PBC48/ECE-3400-Fall-2018/README.md

# ECE-3400-Fall-2018

Link to team website: https://pbc48.github.io/ECE-3400-Fall-2018/

Link to Youtube playlist for all clips: https://www.youtube.com/playlist?list=PLlDmQrapOPoI81cNX5rbt9q5gyuW65E6B
