PBC48/ECE-3400-Fall-2018/lab01/lab01.md

# Lab 01

## Blink

## The Serial Monitor and Analog Pins

## LED Analog Output

## Servos

## Robot
