PBC48/ECE-3400-Fall-2018/45593376_284451068862124_2819931915732123648_n.jpg

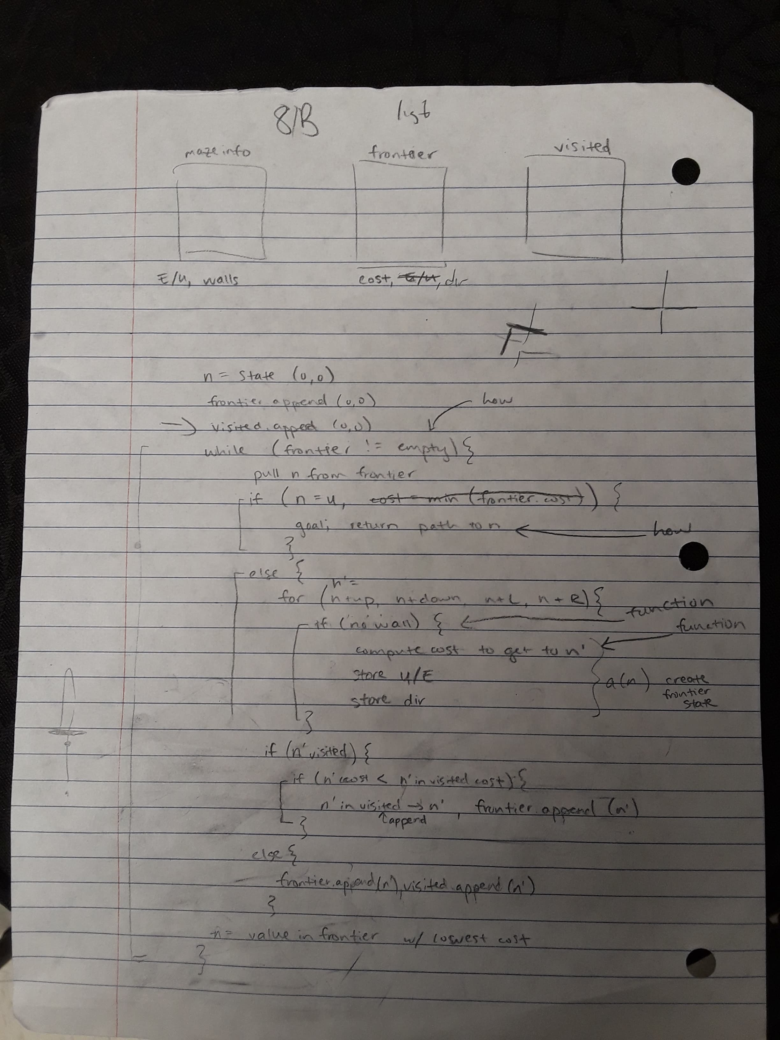
45593376_284451068862124_2819931915732123648_n.jpg
