PBC48/ECE-3400-Fall-2018/docs/css/background-bubbles.jpg

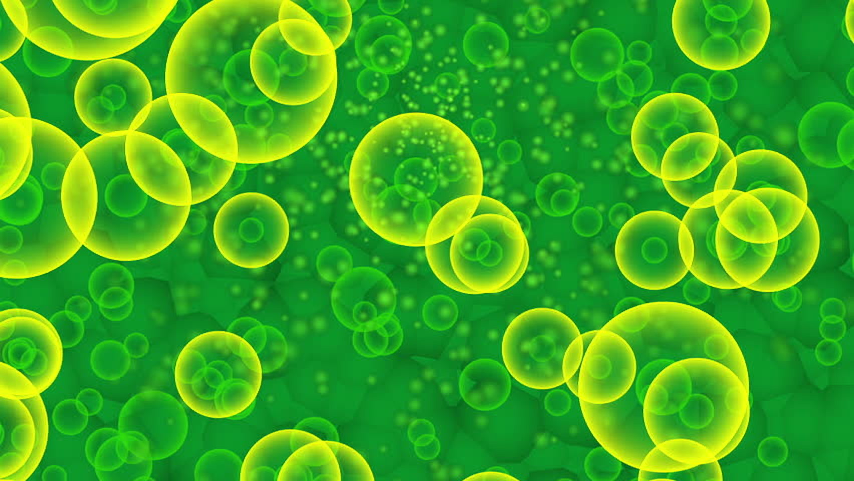
docs/css/background-bubbles.jpg
