PBC48/ECE-3400-Fall-2018/docs/css/bubbles-gif.gif

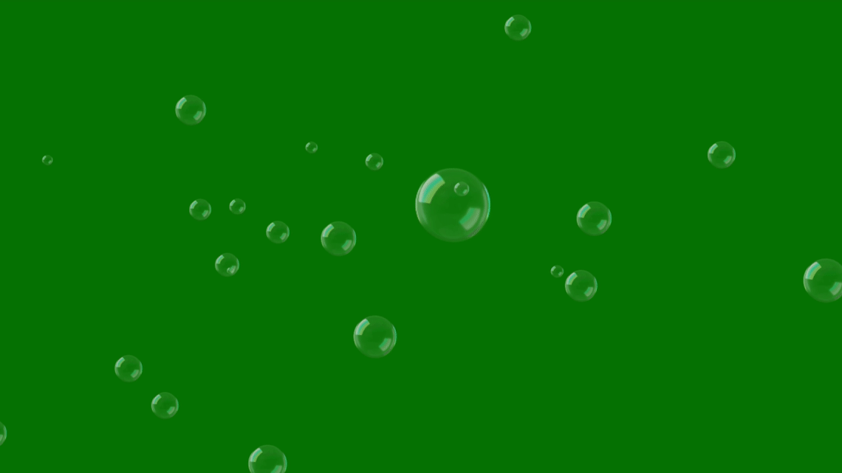
docs/css/bubbles-gif.gif
