PBC48/ECE-3400-Fall-2018/docs/images/bootstrap/contracts.gif

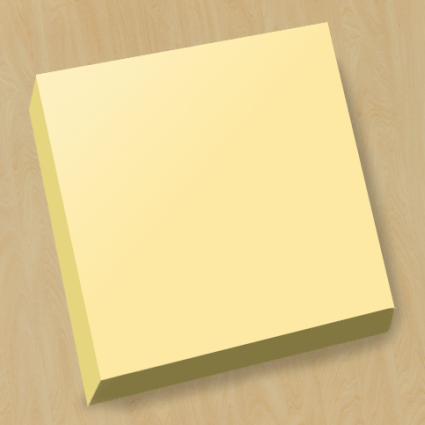
docs/images/bootstrap/contracts.gif
