PBC48/ECE-3400-Fall-2018/docs/images/bootstrap/ethics.gif

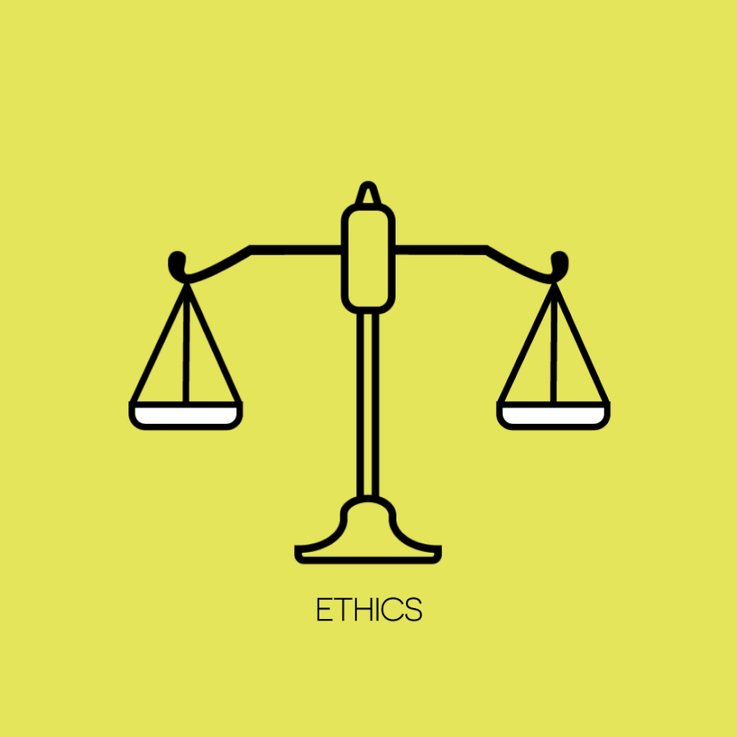
docs/images/bootstrap/ethics.gif
