PBC48/ECE-3400-Fall-2018/docs/images/bootstrap/header.png

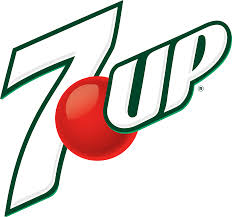
docs/images/bootstrap/header.png
