PBC48/ECE-3400-Fall-2018/docs/images/bootstrap/lab2-bootstrap.png

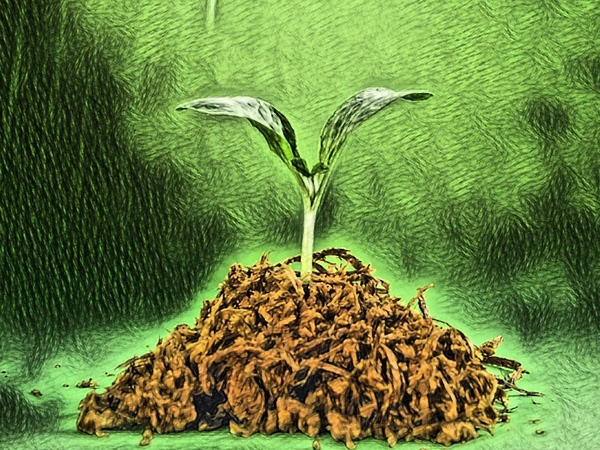
docs/images/bootstrap/lab2-bootstrap.png
