PBC48/ECE-3400-Fall-2018/docs/images/bootstrap/milestone1.png

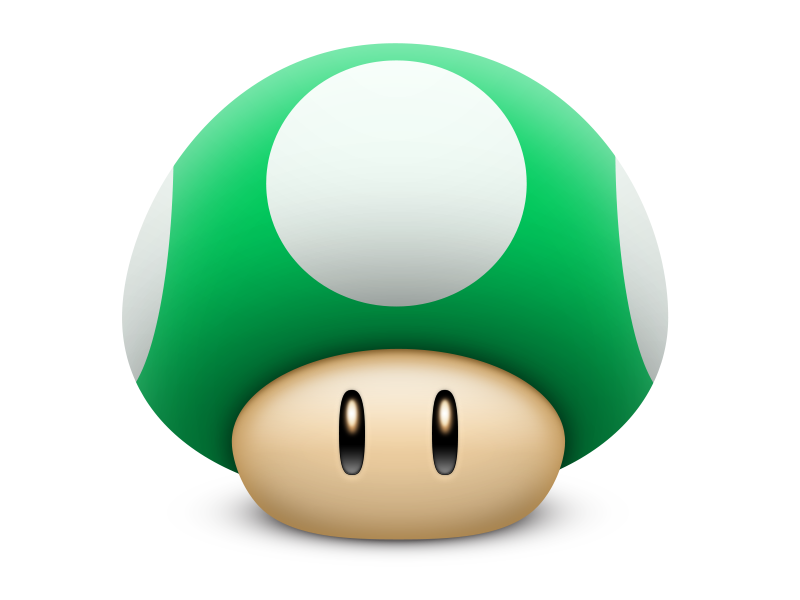
docs/images/bootstrap/milestone1.png
