PBC48/ECE-3400-Fall-2018/docs/images/bootstrap/milestone2.gif

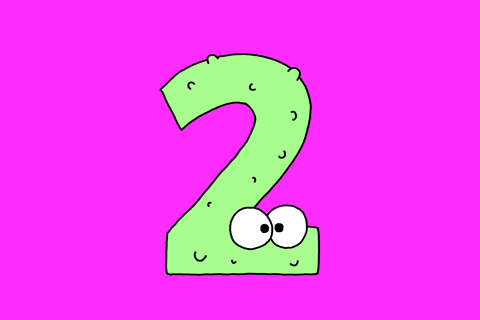
docs/images/bootstrap/milestone2.gif
