PBC48/ECE-3400-Fall-2018/docs/images/bootstrap/milestone4.gif

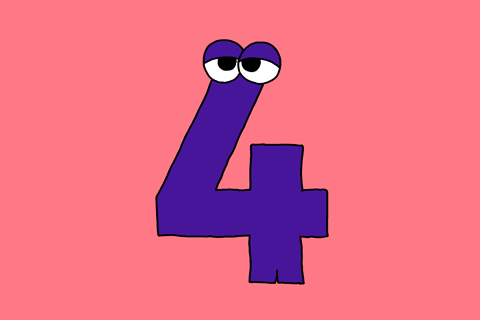
docs/images/bootstrap/milestone4.gif
