PBC48/ECE-3400-Fall-2018/docs/images/Code-serial.PNG

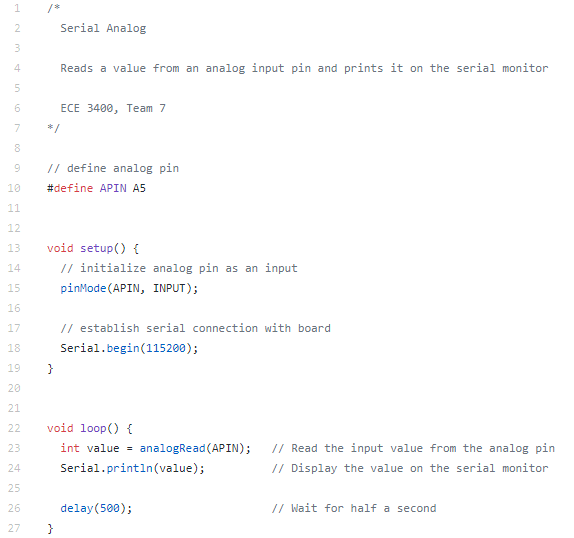
docs/images/Code-serial.PNG
