PBC48/ECE-3400-Fall-2018/docs/images/final_competition/IMG_1189.jpg

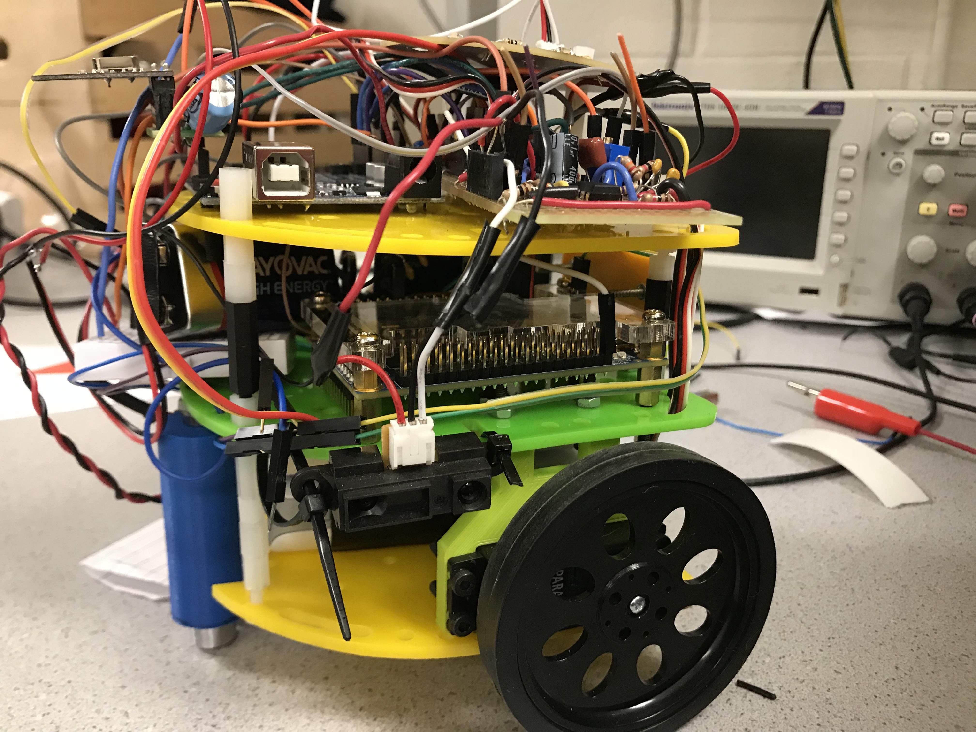
docs/images/final_competition/IMG_1189.jpg
