PBC48/ECE-3400-Fall-2018/docs/images/final_competition/labelrobot6.png

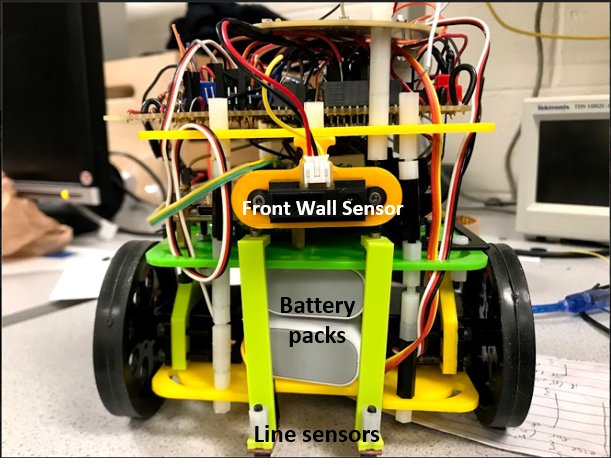
docs/images/final_competition/labelrobot6.png
