PBC48/ECE-3400-Fall-2018/docs/images/final_competition/schematics.PNG

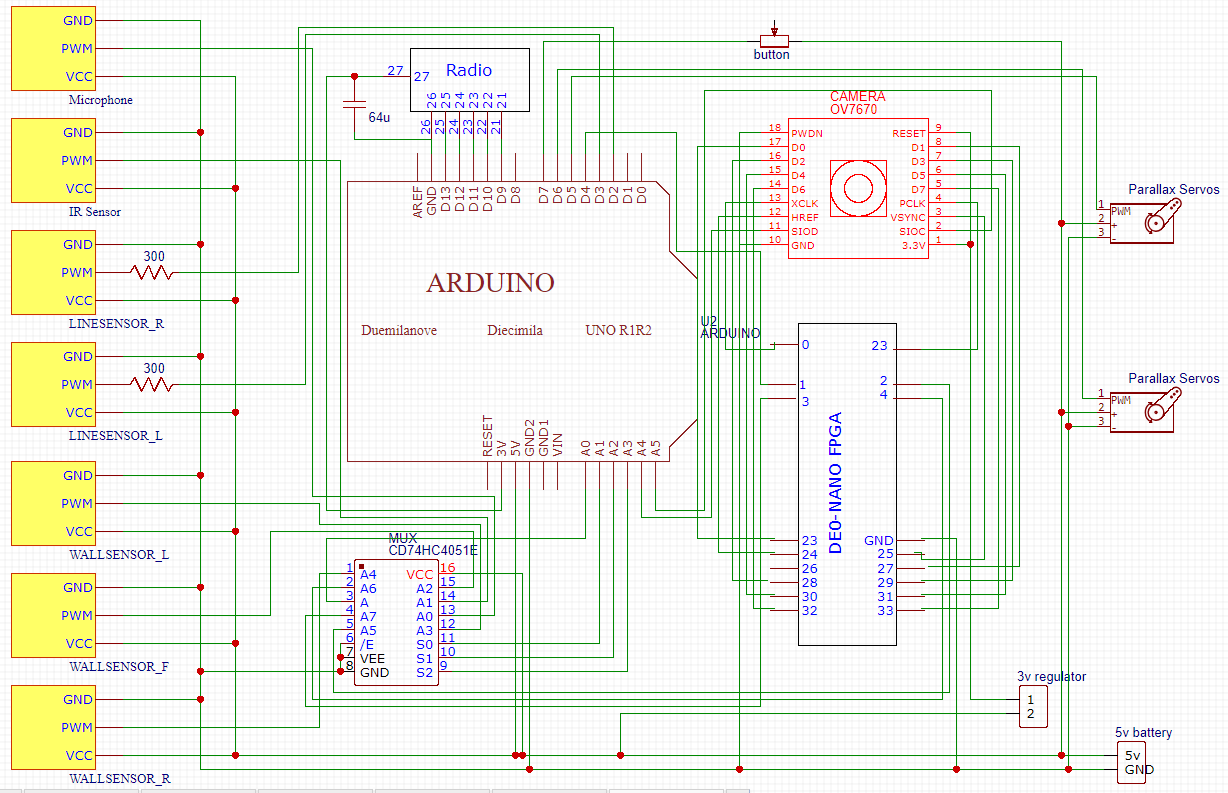
docs/images/final_competition/schematics.PNG
