PBC48/ECE-3400-Fall-2018/docs/images/headshot-Chrissy.png

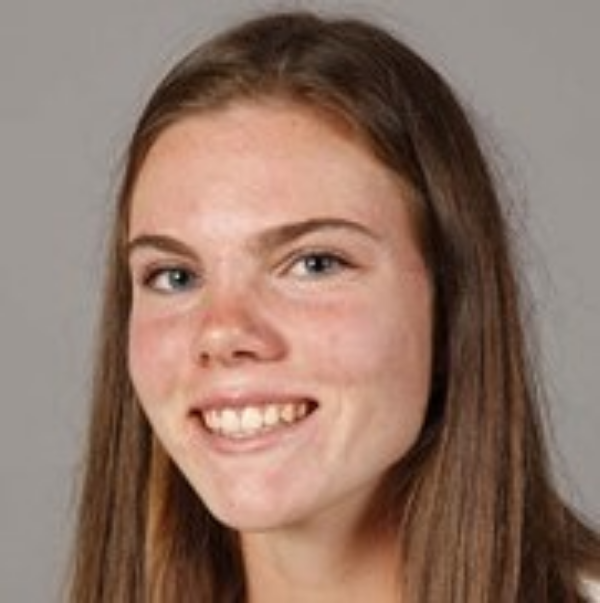
docs/images/headshot-Chrissy.png
