PBC48/ECE-3400-Fall-2018/docs/images/headshot-Patrick.jpeg

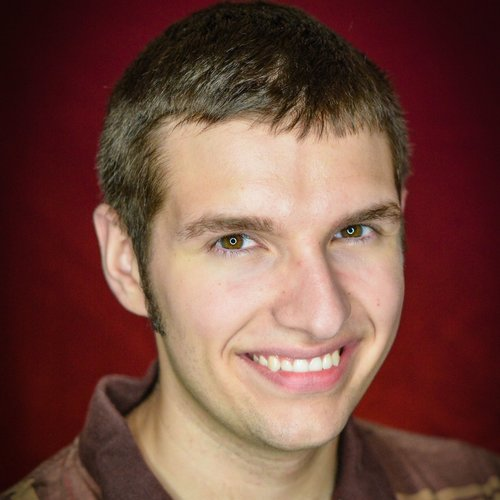
docs/images/headshot-Patrick.jpeg
