PBC48/ECE-3400-Fall-2018/docs/images/headshot-Xiaoyu.PNG

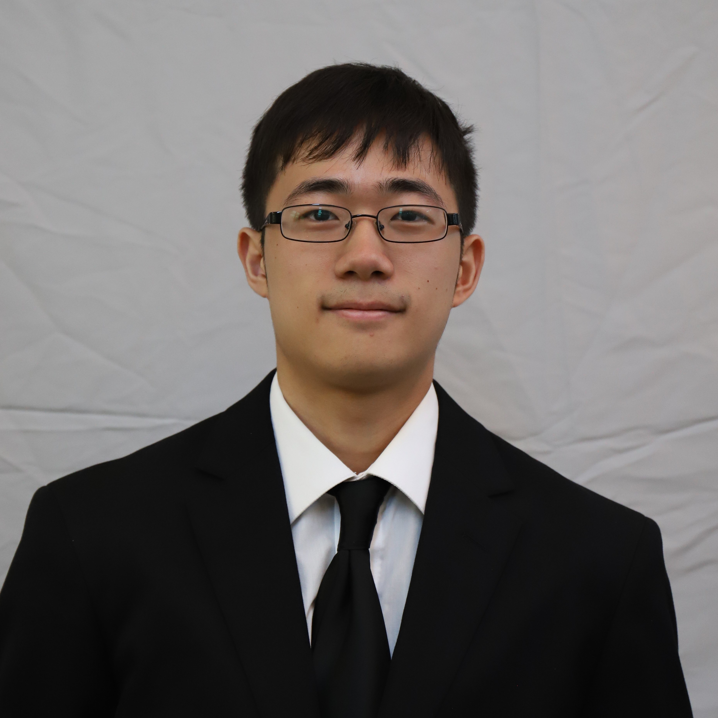
docs/images/headshot-Xiaoyu.PNG
