PBC48/ECE-3400-Fall-2018/docs/images/lab02/amp_input2.jpg

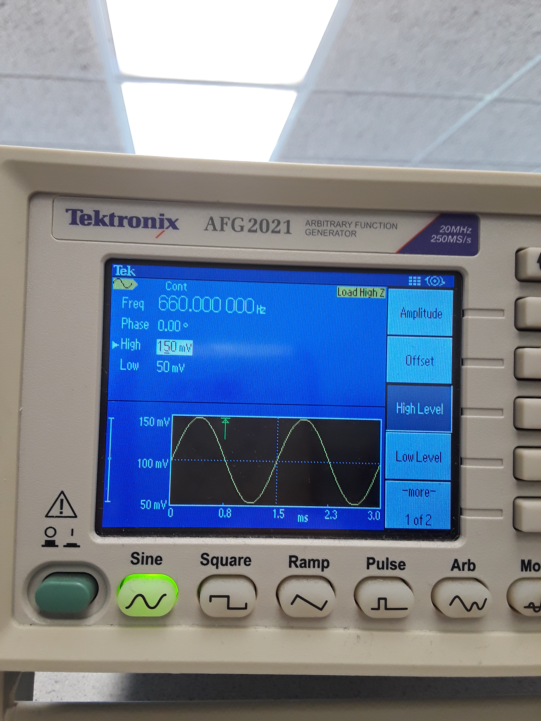
docs/images/lab02/amp_input2.jpg
