PBC48/ECE-3400-Fall-2018/docs/images/lab02/amp_output.jpg

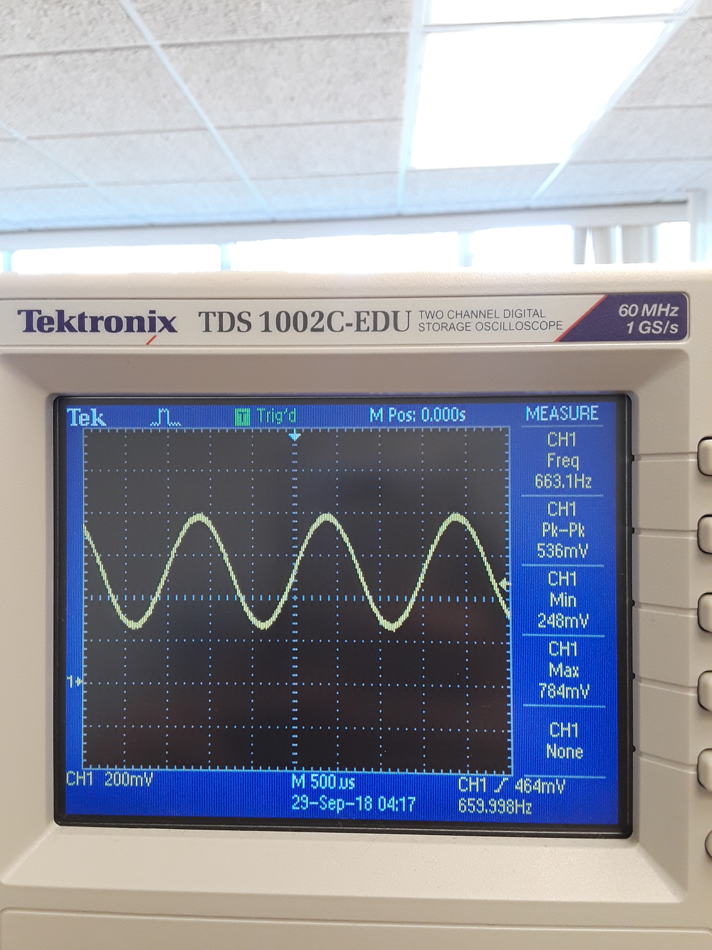
docs/images/lab02/amp_output.jpg
