PBC48/ECE-3400-Fall-2018/docs/images/lab02/IMG_1043.JPG

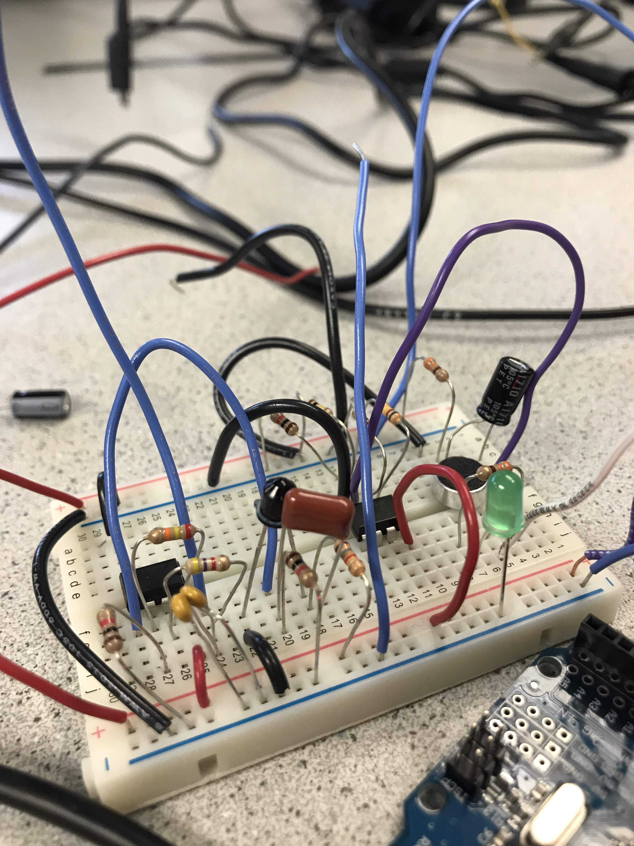
docs/images/lab02/IMG_1043.JPG
