PBC48/ECE-3400-Fall-2018/docs/images/lab02/Lab2integrated_1.PNG

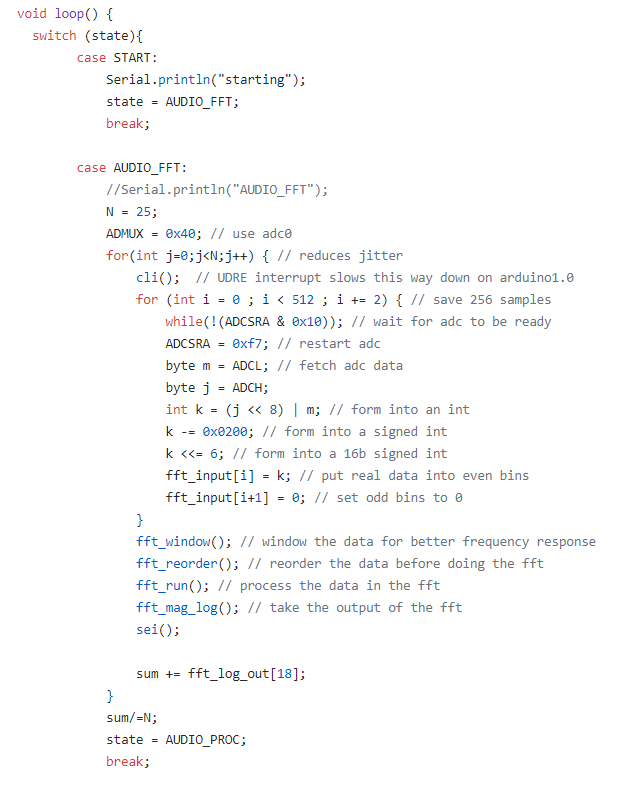
docs/images/lab02/Lab2integrated_1.PNG
