PBC48/ECE-3400-Fall-2018/docs/images/lab02/Lab2integratedcode_2.PNG

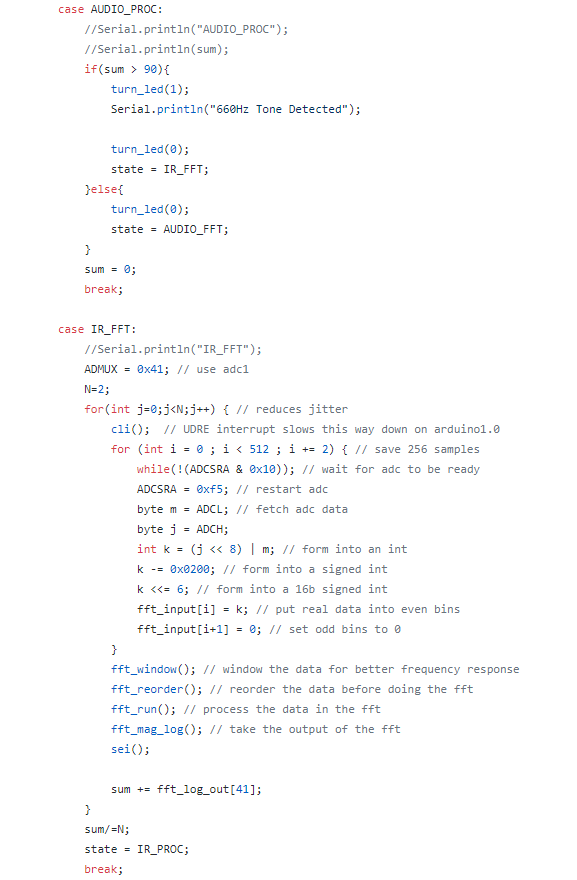
docs/images/lab02/Lab2integratedcode_2.PNG
