PBC48/ECE-3400-Fall-2018/docs/images/lab04/IMG_1161.jpg

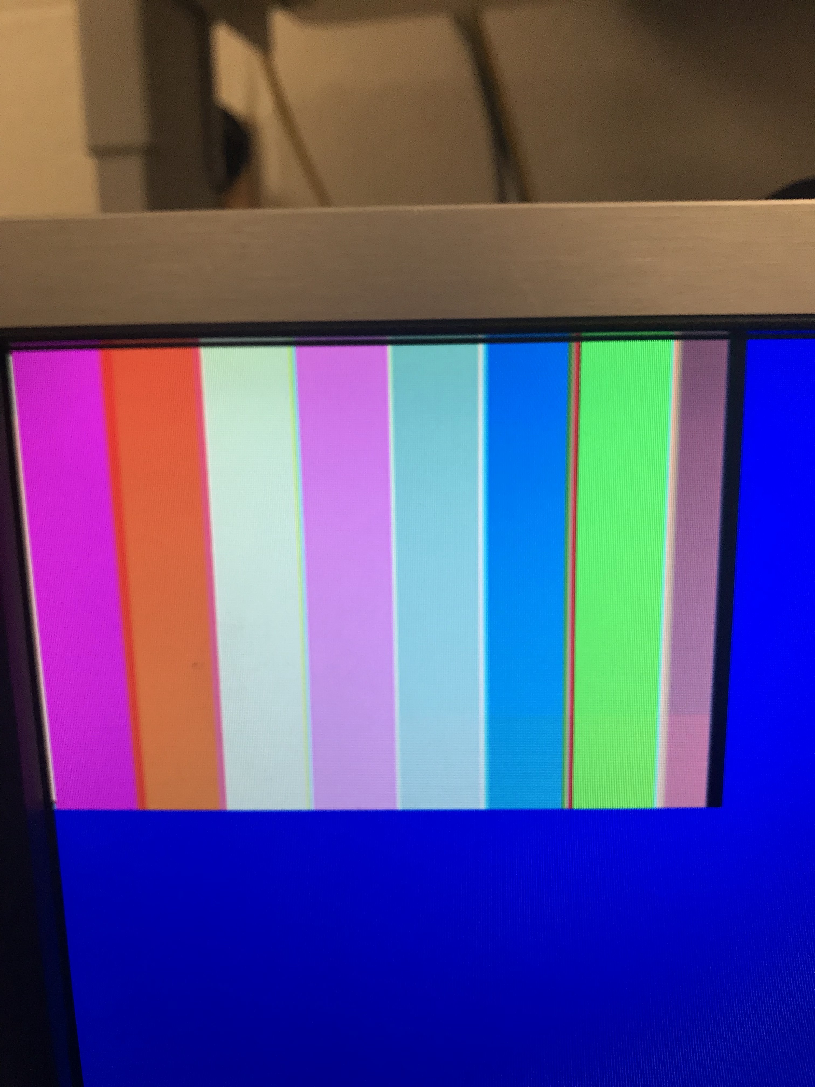
docs/images/lab04/IMG_1161.jpg
