PBC48/ECE-3400-Fall-2018/docs/images/lab04/IMG_1173.jpg

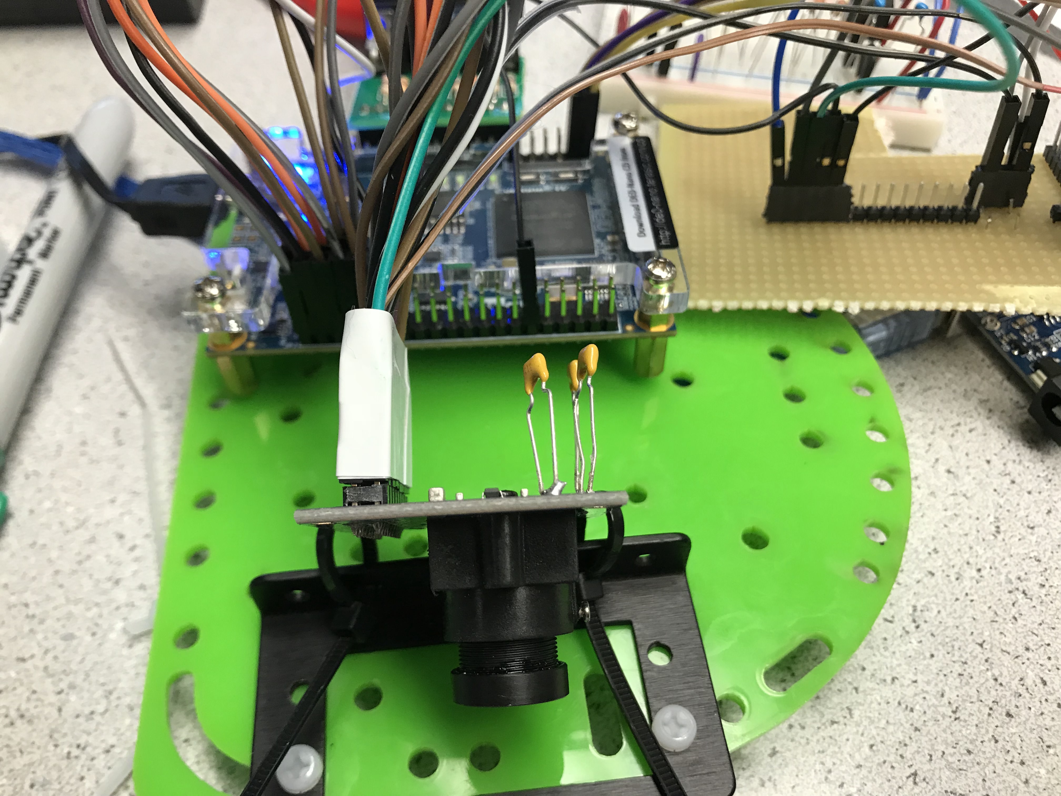
docs/images/lab04/IMG_1173.jpg
