PBC48/ECE-3400-Fall-2018/docs/images/milestone1/20180910_213503.jpg

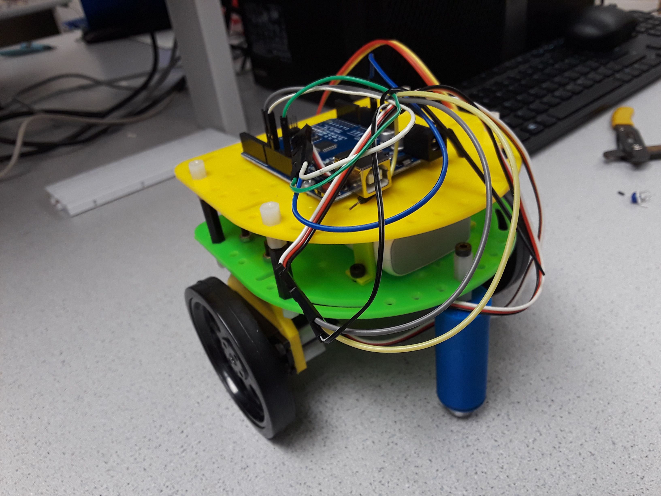
docs/images/milestone1/20180910_213503.jpg
