PBC48/ECE-3400-Fall-2018/docs/images/milestone1/20180913_204701.jpg

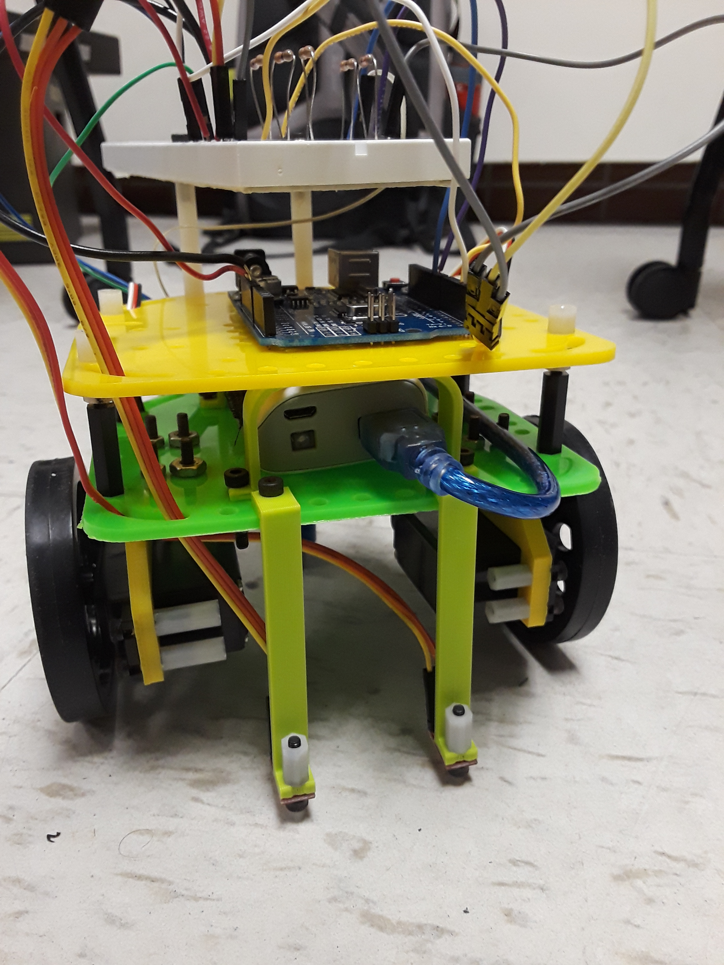
docs/images/milestone1/20180913_204701.jpg
