PBC48/ECE-3400-Fall-2018/docs/images/milestone2/20181017_224123.jpg

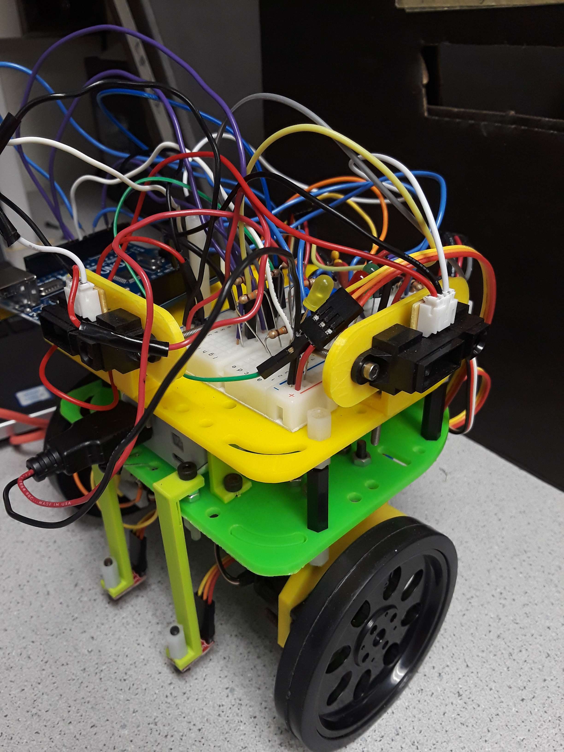
docs/images/milestone2/20181017_224123.jpg
