PBC48/ECE-3400-Fall-2018/docs/images/milestone2/line_sensor_spacers.jpg

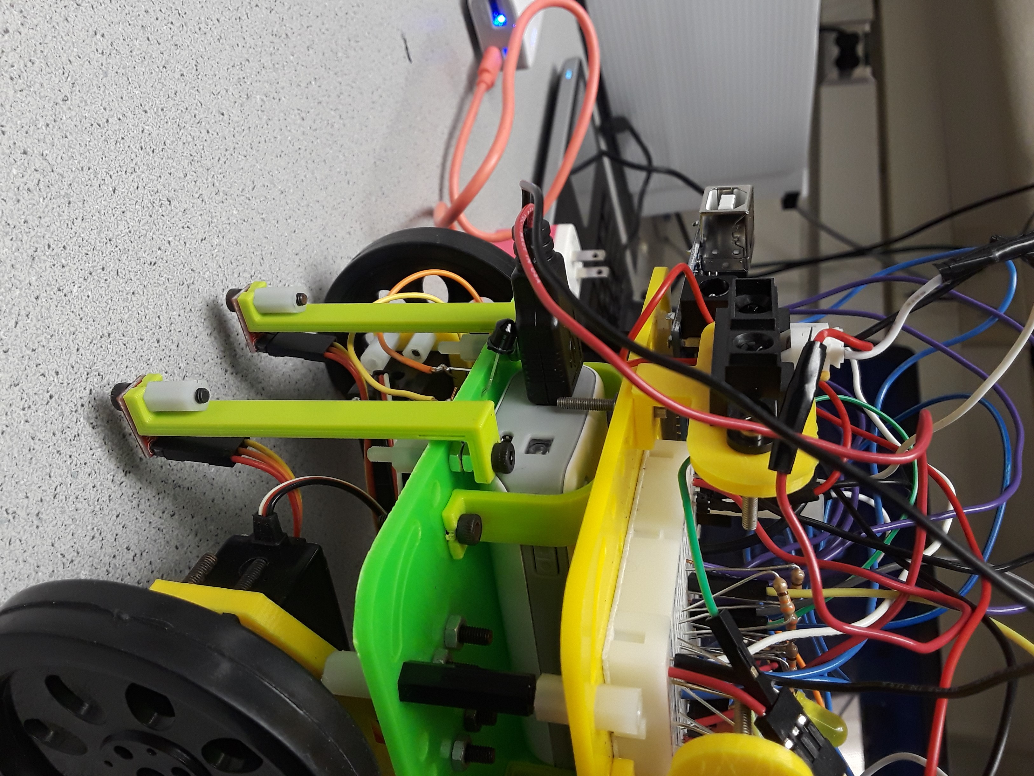
docs/images/milestone2/line_sensor_spacers.jpg
