PBC48/ECE-3400-Fall-2018/docs/images/milestone2/phototransistor.jpg

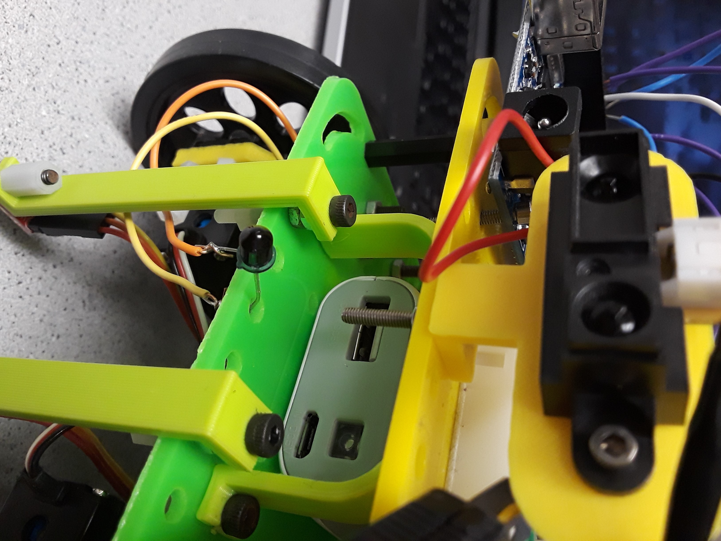
docs/images/milestone2/phototransistor.jpg
