PBC48/ECE-3400-Fall-2018/docs/images/Muxing.png

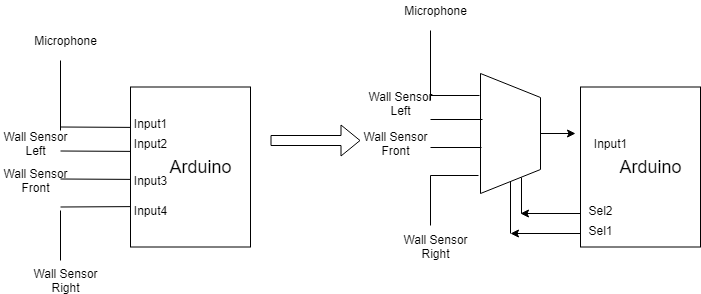
docs/images/Muxing.png
