PBC48/ECE-3400-Fall-2018/docs/images/robottop-v1.PNG

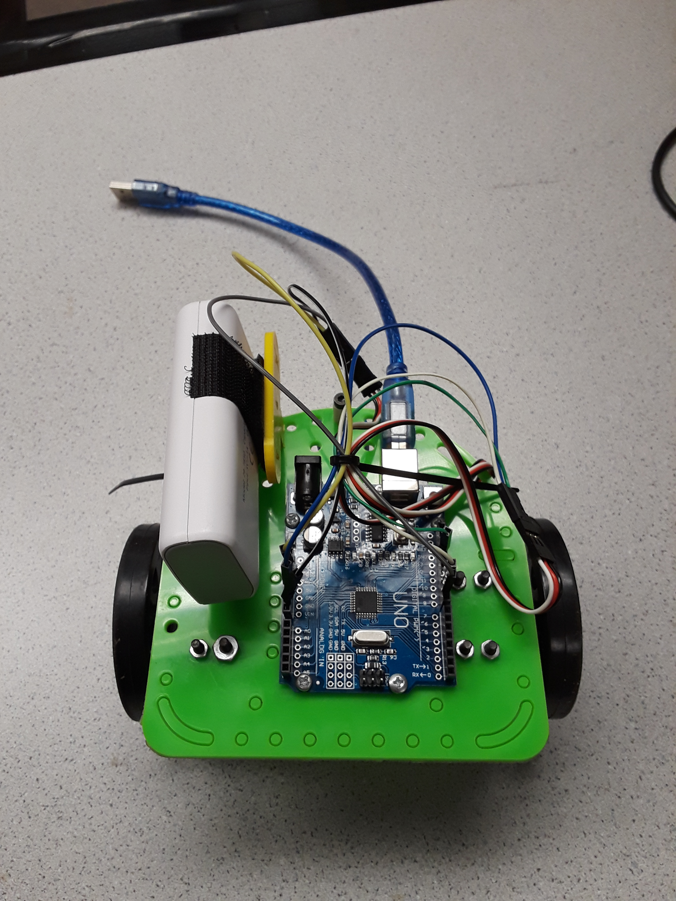
docs/images/robottop-v1.PNG
