PBC48/ECE-3400-Fall-2018/docs/images/robotv1.PNG

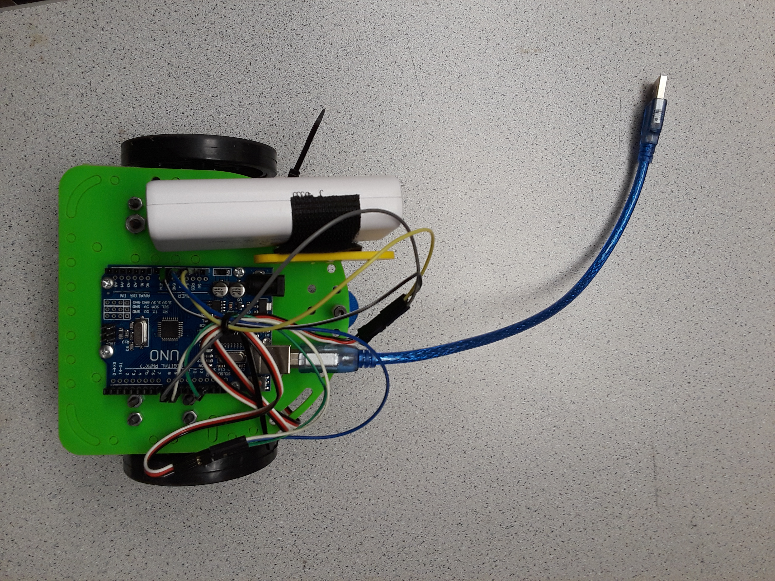
docs/images/robotv1.PNG
