PBC48/ECE-3400-Fall-2018/docs/images/taravn_headshot.jpg

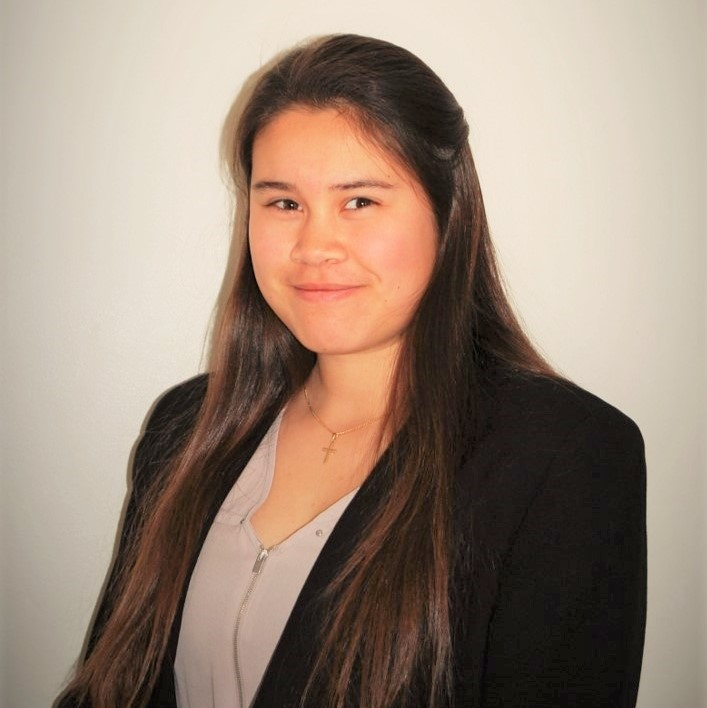
docs/images/taravn_headshot.jpg
