PBC48/ECE-3400-Fall-2018/round1.PNG

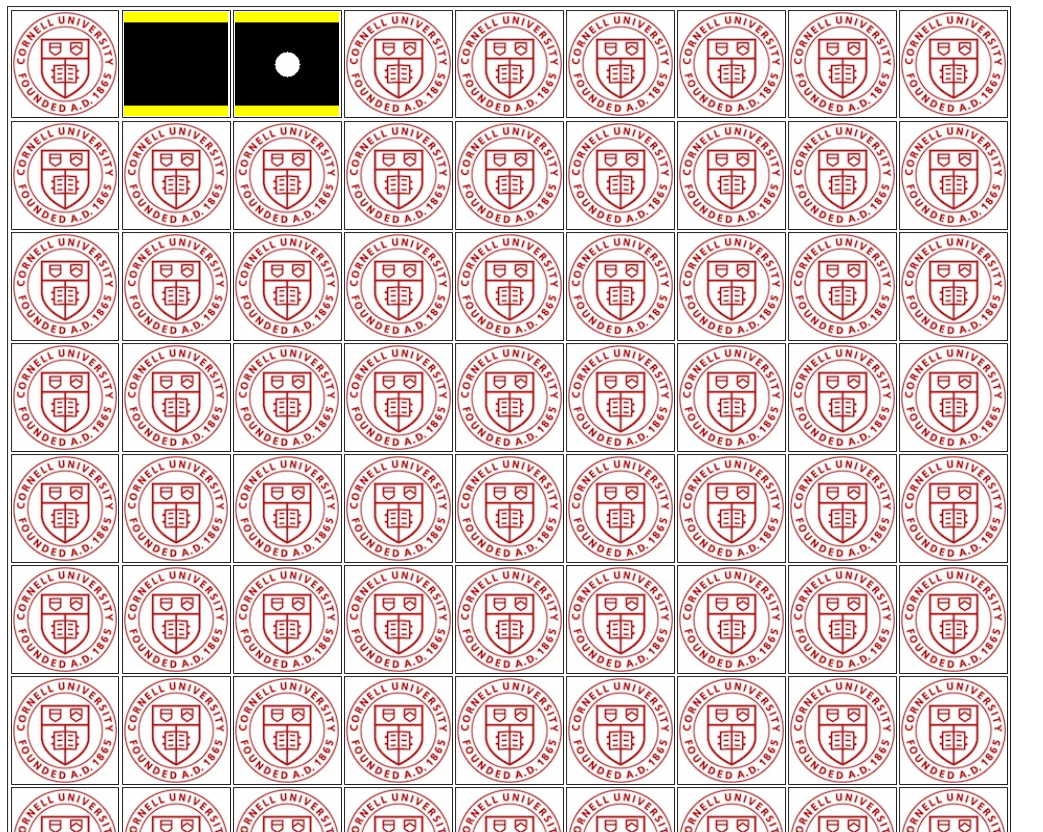
round1.PNG
