PBC48/ECE-3400-Fall-2018/(list of files, cad)

Other CAD files:
blueprints/Battery_mount_tall.dwg
blueprints/bottom_plate.dwg
blueprints/bottom layer w arduino holes.dwg
blueprints/top layer.dwg
