PBC48/ECE-3400-Fall-2018/docs/images/bootstrap/soldering.png

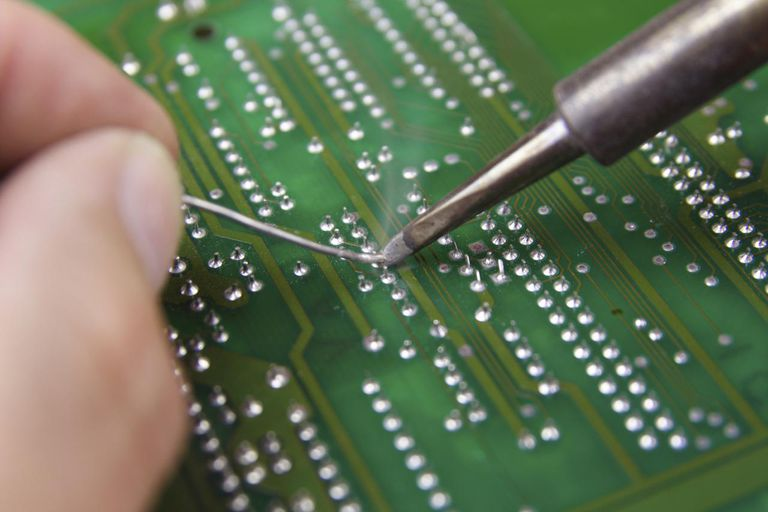
docs/images/bootstrap/soldering.png
