PBC48/ECE-3400-Fall-2018/milestone 4/m4/robot.h

#include <Servo.h>

#define ROBOT_RIGHT_PIN 5
#define ROBOT_LEFT_PIN 6

Servo R;
Servo L;
enum DIRECTIONS : uint8_t
{
    right=1,
    left,
    forward,
    rstop,
    adj_right,
    adj_left,
    back
};

DIRECTIONS current_state;

void robot_move(DIRECTIONS dir)
{
    if (current_state != dir)
    {
        if (dir != rstop && (!R.attached() || !L.attached()))
        {
            Serial.println("in if attach");
            R.attach(ROBOT_RIGHT_PIN);
            L.attach(ROBOT_LEFT_PIN);
        }
        else if (dir == rstop)
        {
            R.detach();
            L.detach();
        }
        switch (dir)
        { //NEED SOME CALIBRATION
        case right:
            L.write(180);
            R.write(95);
            //Serial.println("right");
            break;
        case left:
            L.write(85);
            R.write(0);
            //Serial.println("left");
            break;
        case forward:
            //L.write(150);
            //R.write(30);
            L.write(180);
            R.write(0);
            //Serial.println("forward");
            break;
        case rstop:
            L.write(90);
            R.write(90);
            Serial.println("stopped");
            break;
        case adj_left:
            L.write(90);
            R.write(0);
            //Serial.println("adjust left");
            break;
        case adj_right:
            L.write(180);
            R.write(90);
            //Serial.println("adjust right");
            break;
        case back:
            L.write(0);
            R.write(180);
            Serial.println("back");
            break;
        }
        delay(25); //update the PWM every 20-30 ms.
        current_state = dir;
    }
}

void robot_init()
{
    R.attach(ROBOT_RIGHT_PIN);
    L.attach(ROBOT_LEFT_PIN);
    current_state = 0;
    robot_move(rstop);
}

void servo_detach(){
  R.detach();
  L.detach();
}

void robot_calibrate()
{
    robot_move(right);
    delay(10000);
    robot_move(left);
    delay(10000);
    robot_move(forward);
    delay(10000);
    robot_move(rstop);
    delay(10000);
    robot_move(back);
    delay(10000);
}
