PBC48/ECE-3400-Fall-2018/Milestone 3/milestone3_complicated/milestone3_complicated.ino

/*
milestone 2 code with FSMs where we integrated line sensor, wall 
sensor, robot movement, microphone, and ir all in one.
*/

#define MUX_OUT A0
#define MUX_0 A1
#define MUX_1 A2
#define MUX_2 A3

#define WAITTIME 800
#define BUTTON 7 //Digital pin for button

#include "robot.h"
#include "line_sensor.h"
#include "fft_lib.h"
#include "radio.h"
#include "path.h"
#include "maze.h"


uint8_t robot_pos;


enum states : uint8_t
{
    START,
    AUDIO_DECT,
    IR_DECT,
    ROBOT_SENSE,
    ROBOT_DETECTED,
    ROBOT_TURN_LEFT,
    ROBOT_TURN_RIGHT,
    ROBOT_FORWARD,
    ROBOT_U_TURN,
    TRANSMIT
};

uint8_t STATE;
uint32_t u32wait;
uint32_t u32wait_ir;
uint16_t radio_msg = 0;
uint16_t FRONTWALL;
uint16_t LEFTWALL;
uint16_t RIGHTWALL;

void toggle_LED(uint8_t &pin)
{
    int set = digitalRead(pin) ? LOW : HIGH;
    digitalWrite(pin, set);
}

void send_to_baseStation()
{
    robot_move(rstop);
    servo_detach();
    line_sensor_detach();
    while(!radio_transmit(radio_msg));
    line_sensor_init();
    radio_msg = radio_msg & 0x1FF;
}

void set_mux_select(byte device)
{
  switch(device) {

    case 0: // MICROPHONE
      digitalWrite(MUX_0,LOW);
      digitalWrite(MUX_1,LOW);
      digitalWrite(MUX_2,LOW);
      Serial.println("Set mux: microphone");
      break; 

    case 1: // IR SENSOR
      digitalWrite(MUX_0,HIGH);
      digitalWrite(MUX_1,LOW);
      digitalWrite(MUX_2,LOW);
      Serial.println("Set mux: IR sensor");
      break;

    case 2: // WALL SENSOR FRONT
      digitalWrite(MUX_0,LOW);
      digitalWrite(MUX_1,HIGH);
      digitalWrite(MUX_2,LOW);
      Serial.println("Set mux: front wall sensor");
      break;

    case 3: // WALL SENSOR LEFT
      digitalWrite(MUX_0,HIGH);
      digitalWrite(MUX_1,HIGH);
      digitalWrite(MUX_2,LOW);
      Serial.println("Set mux: left wall sensor");
      break;

    case 4: // WALL SENSOR RIGHT
      digitalWrite(MUX_0,LOW);
      digitalWrite(MUX_1,LOW);
      digitalWrite(MUX_2,HIGH);
      Serial.println("Set mux: right wall sensor");
      break;

    default:
      Serial.println("Mux not set");
      break;
  }
  delay(0.5); //1 to be safe? (500ns)
}


void setup()
{
    Serial.begin(115200); // Not 115200?
    line_sensor_init();
    radio_init(role_ping_out);
    STATE = START;
    u32wait = millis();
    for (int i = 0; i<9; i++){
      for(int j = 0; j<9; j++){
        maze[i][j] = 0;
      }
    }
    pinMode(MUX_0, OUTPUT);
    pinMode(MUX_1, OUTPUT);
    pinMode(MUX_2, OUTPUT);
}


void loop()
{
    //Serial.print(F("State: "));Serial.println(STATE);
    switch (STATE)
    {
    case START:
        Serial.println(F("start"));
        set_mux_select(0);
        //radio_msg = 0;
        //radio_msg = millis();
        //radio_transmit(radio_msg);

        delay(1000);
        STATE = AUDIO_DECT;

        break;

    case AUDIO_DECT:
        calculate_FFT(MIC);
        Serial.print(F("AUDIO SUM: "));
        Serial.println(sum);
        if (sum > 145)
        { //|| digitalRead(BUTTON)){ //originally at 90
            Serial.println(F("660Hz Tone Detected"));
            STATE = IR_DECT;
            robot_init();
        }
        else
        {
            STATE = AUDIO_DECT;
        }
        //STATE = IR_DECT;
        //radio_msg = millis();
        //radio_transmit(radio_msg);
        break;

    case IR_DECT:
        set_mux_select(1);
        calculate_FFT(IR);
        Serial.println("IN IR_DECT");
        Serial.print(F("IR SUM: ")); Serial.println(sum);
        if (sum > 100)
        {
            Serial.println(F("Robot Detected"));
            STATE = ROBOT_DETECTED;
        }
        else
        {
            STATE = ROBOT_SENSE; //LINE_SENSOR;
        }
        u32wait_ir = millis();
        break;

    case ROBOT_SENSE:

        //structure: 000000vb ddtttrfl
        // d = direction robot will travel; t = treasure; b = robot
        // f = front wall; r = right wall; l = left wall; v = valid
        // we add a valid bit so that the robot wouldn't stall at intersection.
        // May consider queue.
        //Serial.println(F("IN ROBOT_SENSE"));
        //Serial.print(F("SENSOR_R READING: "));Serial.println(SENSOR_R_READING);
        //Serial.print(F("SENSOR_L READING: "));Serial.println(SENSOR_L_READING);
        //Serial.print(F("FRONTWALL: "));Serial.println(FRONTWALL);
        //Serial.print(F("LEFTWALL: "));Serial.println(LEFTWALL);

        //Serial.print(F("SENSOR_R READING: "));
        //Serial.println(AVERAGE_R);
        //Serial.print(F("SENSOR_L READING: "));
        //Serial.println(AVERAGE_L);
            
        if (AVERAGE_L < 200 && AVERAGE_R < 200 && VALID_L && VALID_R)
        {
            Serial.print(F("SENSOR_R READING: "));
            Serial.println(AVERAGE_R);
            Serial.print(F("SENSOR_L READING: "));
            Serial.println(AVERAGE_L);
            Serial.println(F("In intersection"));
            byte dir;
            radio_msg = 0;
            set_mux_select(2);
            FRONTWALL = analogRead(MUX_OUT);
            //Serial.print(F("FRONTWALL: "));Serial.println(FRONTWALL);
            set_mux_select(3);
            LEFTWALL = analogRead(MUX_OUT);
            //Serial.print(F("LEFTWALL: "));Serial.println(LEFTWALL);
            set_mux_select(4);
            RIGHTWALL = analogRead(MUX_OUT);
            //Serial.print(F("RIGHTWALL: "));Serial.println(RIGHTWALL);

            /*
             * if (unexplored){
             *    update maze info
             *    find_path(pos, dir);
             * }
             * 
             * decide robot direction based on istruction list
             */

            if(LEFTWALL > 100 && FRONTWALL > 100 && RIGHTWALL >100){
                dir = 3;
                STATE = ROBOT_U_TURN;
            }
            else if (LEFTWALL < 200)
            {
                dir = 2;
                STATE = ROBOT_TURN_LEFT;
            }
            else if (FRONTWALL > 100)
            {
                dir = 1;
                STATE = ROBOT_TURN_RIGHT;
            }
            else
            {
                dir = 0;
                STATE = ROBOT_FORWARD;
                //robot_move(forward);
            }
            
            //radio_msg = millis();
            radio_msg = 0x3FF & ((1 << 9) | radio_msg |                                              //setting valid bit.
                                  (dir << 6) | ((LEFTWALL > 115)) | (FRONTWALL > 115)<<1)| ((RIGHTWALL > 115)<<2);

            u32wait = millis();
            VALID_L = false;
            VALID_R = false;
        }
        else
        {
            if (SENSOR_L_READING < 200)
            {
                robot_move(adj_right);
                //Serial.println("Adjust right");
            }
            else if (SENSOR_R_READING < 200)
            {
                robot_move(adj_left);
                //Serial.println("Adjust left");
            }
            else
            {
                robot_move(forward);
                //Serial.println("Moving");
            }
            if ((millis() - u32wait_ir) > WAITTIME)
            {
                STATE = IR_DECT;
            }
            else if ((radio_msg >> 9) & 0x1)
            {
                STATE = TRANSMIT;
            }
        }

        break;

    case ROBOT_DETECTED:
        robot_move(rstop);
        STATE = IR_DECT;
        break;

    case ROBOT_TURN_LEFT:
        robot_move(left);
        if (millis() - u32wait > 700)
        {
            STATE = ROBOT_SENSE;
        }
        break;

    case ROBOT_TURN_RIGHT:
        robot_move(right);
        if (millis() - u32wait > 700)
        {
            STATE = ROBOT_SENSE;
        }
        break;

    case ROBOT_FORWARD:
        robot_move(forward);
        if (millis() - u32wait > 200)
        {
            STATE = ROBOT_SENSE;
        }
        break;

    case ROBOT_U_TURN:
        robot_move(right);
        if(millis()-u32wait > 1400)
        {
            STATE = ROBOT_SENSE;
        }
        break;

    case TRANSMIT:
        //radio_transmit(radio_msg);
        send_to_baseStation();
        
        STATE = ROBOT_SENSE;
        break;

    default:
        STATE = ROBOT_SENSE;
        Serial.println(F("state broken"));
        break;
    }
}
