PBC48/ECE-3400-Fall-2018/lab03/arduino-nrf24l01-master/Transmitter/Transmitter.ino

#include <SPI.h>
#include "Mirf.h"
#include <nRF24L01.h>
#include "MirfHardwareSpiDriver.h"

int value;

void setup()
{
  Mirf.spi = &MirfHardwareSpi;
  Mirf.init();
  // Set own address - unique 5 character string
  Mirf.setRADDR((byte *)"ABCDE"); 
  Mirf.payload = sizeof(value);
  Mirf.channel = 90;
  Mirf.config();
}

void loop()
{
  // Set remote address to send to
  Mirf.setTADDR((byte *)"FGHIJ"); 
  value = random(255);
  Mirf.send((byte *)&value);
  while(Mirf.isSending()) delay(1);
  delay(1000);
}
