PBC48/ECE-3400-Fall-2018/lab04/Lab4_FPGA_Template_new/DOWNSAMPLER.v

module DOWNSAMPLER (
	input           RES,
	input           CLK,
	input  [7:0]    D,
	input           HREF,
	input           VSYNC,
   output [7:0]    PIXEL,
	output          SAMP_RDY
);
/// I/O ///


reg [15:0]	 temp;
reg [7:0]    OUT;
reg          count_bit;
reg 			 reg_valid;
reg 			 fsm;



assign PIXEL = OUT;
assign SAMP_RDY = reg_valid;

localparam IDLE = 0;
localparam READ = 1;

always @ (posedge CLK) begin
	if(RES) begin
		count_bit <= 1'b0;
		reg_valid <= 1'b0;
		OUT 		 <= 8'd0;
	end
	else if (HREF) begin
		count_bit 		= ~count_bit;
		if(!count_bit) begin
			reg_valid		<= 1'b1;
			OUT[7:2]		 	<= {D[7:5], D[2:0]};
		end
		else begin 
			reg_valid 		<= 1'b0;
			OUT[1:0]			<= D[4:3];
		end
	end
	
end

/*
always @ (posedge CLK) begin
	case (fsm)
		IDLE: begin
			fsm <= (RES && !HREF) ? IDLE : READ;
			count_bit 				= 1'b0;
			reg_valid 				= 1'b0;
			OUT 		 				= 8'd0;
 		end		
		READ: begin
			fsm 					= (RES || VSYNC) ? IDLE : READ;
			if(HREF) begin
				count_bit 		= ~count_bit;
				if(!count_bit) begin
					reg_valid		<= 1'b1;
					OUT[7:2]		 	<= {D[7:5], D[2:0]};
				end
				else begin 
					reg_valid 		<= 1'b0;
					OUT[1:0]			<= D[4:3];
				end
			end
//			if(HREF) begin
//				count_bit 		= ~count_bit;
//				if(count_bit) begin
//					reg_valid		= 1'b1;
//					temp[7:0]		= D;
//					OUT			 	= {temp[15:13], temp[10:8],temp[4:3]};
//				end
//				else begin 
//					temp[15:8]		= D;
//					reg_valid 		= 1'b0;
//					OUT				= 8'd0;
//				end
//			end
			else begin
				count_bit			= 1'b0;
				reg_valid 			= 1'b0;
				OUT					= 8'd0;
			end
		end
	endcase

end*/
   
endmodule
