PBC48/ECE-3400-Fall-2018/Tests/test_wall_sensor/test_wall_sensor.ino

#include "mux.h"
long LEFTWALL,FRONTWALL,RIGHTWALL;

void setup(){
    mux_init();
    Serial.begin(9600);
}

void loop(){
    delay(400);
    
    set_mux_select(2);
    FRONTWALL = analogRead(MUX_OUT);
    Serial.print(F("FRONTWALL: "));
    Serial.print(FRONTWALL);
    set_mux_select(3);
    LEFTWALL = analogRead(MUX_OUT);
    Serial.print(F("-----LEFTWALL: "));
    Serial.print(LEFTWALL);
    set_mux_select(4);
    RIGHTWALL = analogRead(MUX_OUT);
    Serial.print(F("-----RIGHTWALL: "));
    Serial.println(RIGHTWALL);
}
