PBC48/ECE-3400-Fall-2018/lab01/Blink/Blink.ino

int LED_PIN = 3;
int POTEN_PIN = A1;

// the setup function runs once when you press reset or power the board
void setup() {
  Serial.begin(9600);
  // initialize digital pin LED_BUILTIN as an output.
  pinMode(LED_PIN, OUTPUT);
}

// the loop function runs over and over again forever
void loop() {
  int amount = analogRead(POTEN_PIN);
  Serial.println(analogRead(POTEN_PIN));
  digitalWrite(LED_PIN, HIGH);   // turn the LED on (HIGH is the voltage level)
  delay(1000);                       // wait for a second
  digitalWrite(LED_PIN, LOW);    // turn the LED off by making the voltage LOW
  delay(1000);                       // wait for a second
  
  analogWrite(LED_PIN, amount);
}
