PBC48/ECE-3400-Fall-2018/(commit log)

2018-09-07 added schematic
2018-09-07 Added new Schematics
2018-09-08 changed name for servo
2018-10-06 added more pictures
    [IR data.xlsx]
2018-10-06 added to the adc and optical sections
2018-10-12 added led support
2018-11-06 updated FSM
    [DE0_NANO.smp_dump.txt]
2018-11-20 blueprints for bottom plate and battery mount
    [Battery_mount_tall.dwg, bottom_plate.dwg]
2018-11-30 Rename milestone 3/printf.h to Milestone 3/milestone_3/printf.h
2018-11-30 Rename milestone3/printf.h to Milestone 3/milestone3_complicated/printf.h
2018-12-06 Soldering done
